tou2/smart-moisture-sensor/moisture-probe/moisture-probe.kicad_pcb

## KiCad design moisture-probe/moisture-probe.kicad_pcb (2026-11-11)

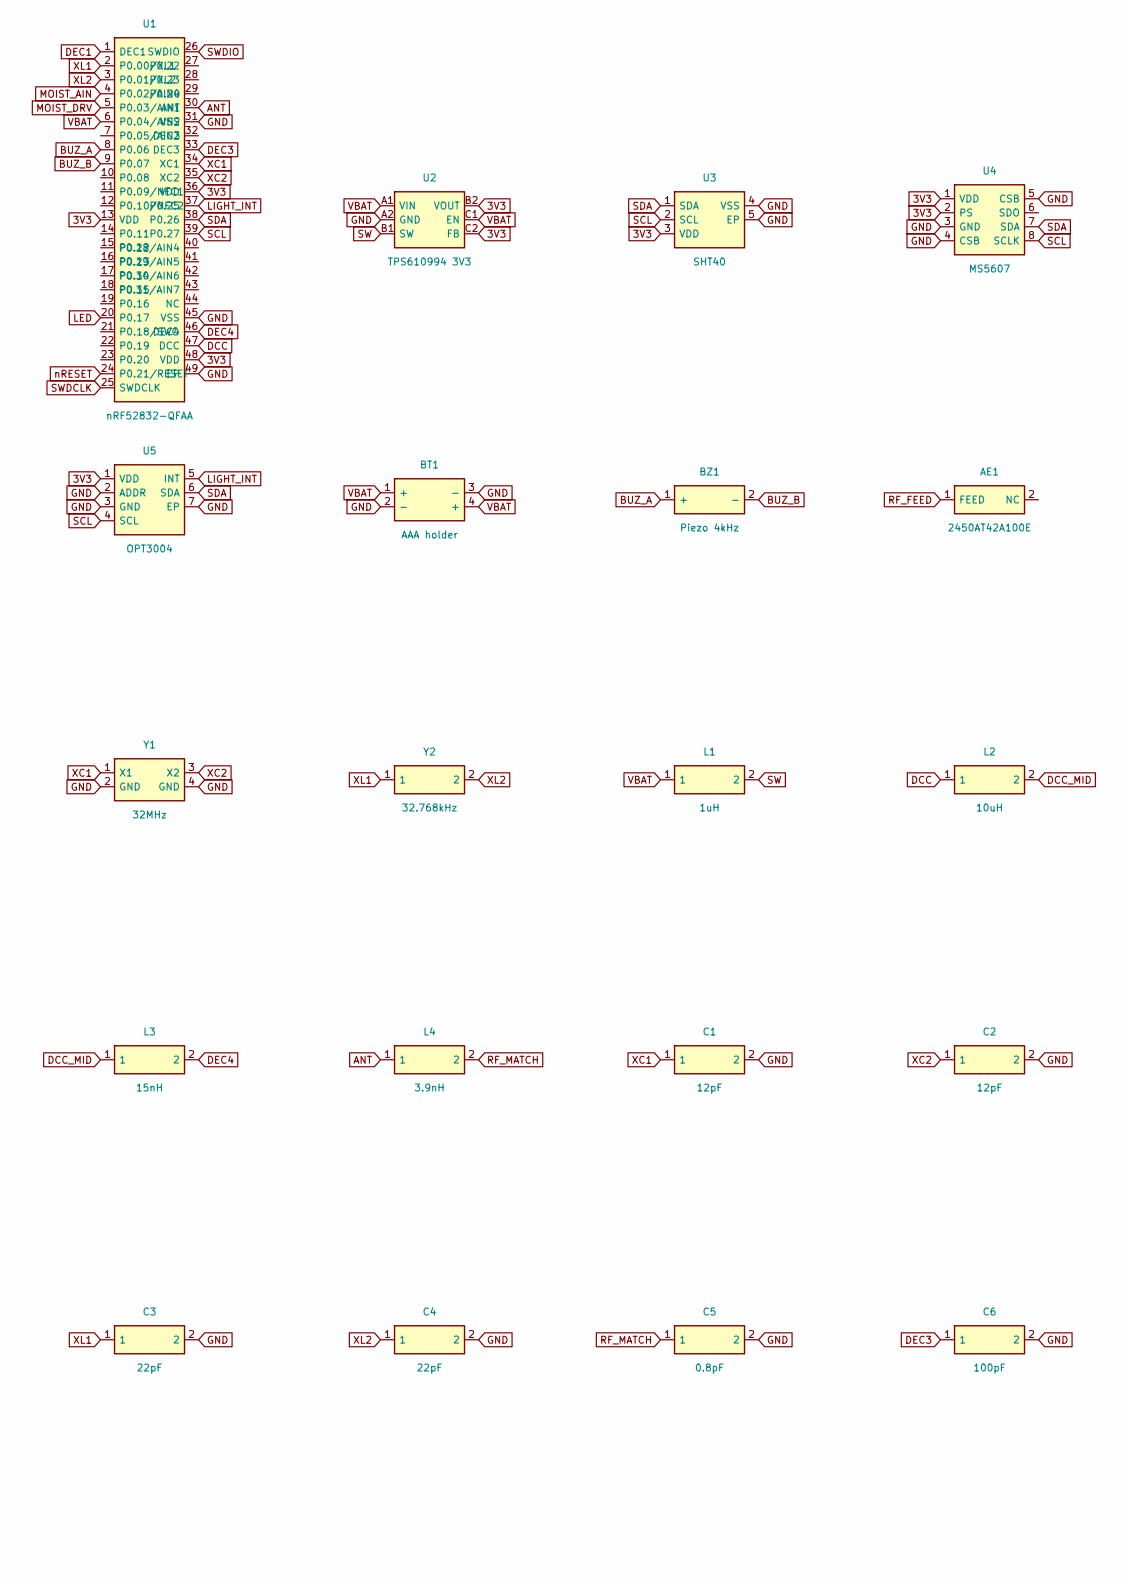
[picture p1: schematic moisture-probe.kicad_sch, part in row 1, column 1]

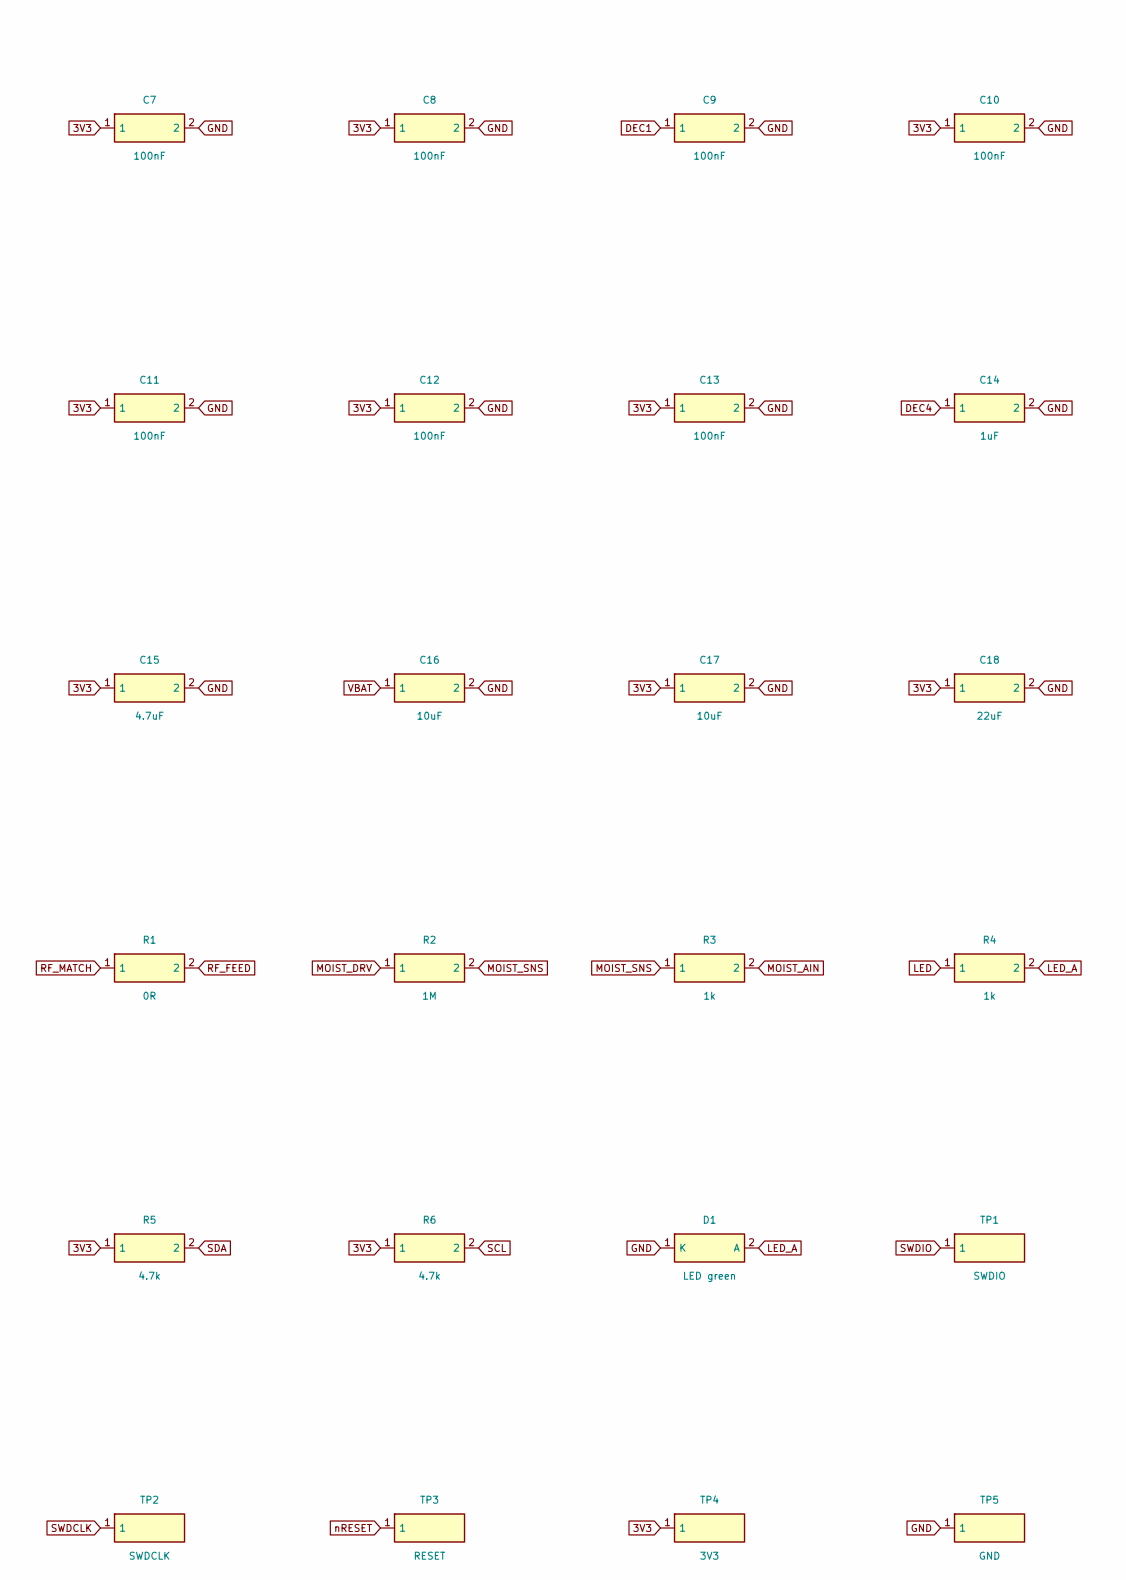
[picture p2: schematic moisture-probe.kicad_sch, part in row 2, column 1]

Parts:
AE1: 2450AT42A100E; C2917719_SMD_5x2mm; LCSC C2917719
BT1: AAA holder; C964881_-; LCSC C964881
BZ1: Piezo 4kHz; C113159_SMD_12x12mm; LCSC C113159
C1, C2: 12pF; C_0402_1005Metric; LCSC C1547
C3, C4: 22pF; C_0402_1005Metric; LCSC C1555
C5: 0.8pF; C_0402_1005Metric; LCSC C327032
C6: 100pF; C_0402_1005Metric; LCSC C1546
C7, C8, C9, C10, C11, C12, C13: 100nF; C_0402_1005Metric; LCSC C1525
C14: 1uF; C_0603_1608Metric; LCSC C15849
C15: 4.7uF; C_0603_1608Metric; LCSC C19666
C16, C17: 10uF; C_0603_1608Metric; LCSC C19702
C18: 22uF; C_0805_2012Metric; LCSC C45783
D1: LED green; LED_0603_1608Metric; LCSC C965806
L1: 1uH; C5349664_SMD_4_4x4_2mm; LCSC C5349664
L2: 10uH; L_0603_1608Metric; LCSC C6807729
L3: 15nH; L_0402_1005Metric; LCSC C98055
L4: 3.9nH; L_0201_0603Metric; LCSC C918993
R1: 0R; R_0402_1005Metric; LCSC C17168
R2: 1M; R_0402_1005Metric; LCSC C26083
R3, R4: 1k; R_0402_1005Metric; LCSC C11702
R5, R6: 4.7k; R_0402_1005Metric; LCSC C25900
TP1: SWDIO; TestPoint_Pad_D1.0mm
TP2: SWDCLK; TestPoint_Pad_D1.0mm
TP3: RESET; TestPoint_Pad_D1.0mm
TP4: 3V3; TestPoint_Pad_D1.0mm
TP5: GND; TestPoint_Pad_D1.0mm
U1: nRF52832-QFAA; C77540_QFN-48-EP_6x6_; LCSC C77540
U2: TPS610994 3V3; C2650335_DSBGA-6; LCSC C2650335
U3: SHT40; C2909890_DFN-4-EP_1_5x1_5_; LCSC C2909890
U4: MS5607; C97627_SMD-8P; LCSC C97627
U5: OPT3004; C2655153_WSON-6-EP_2x2_; LCSC C2655153
Y1: 32MHz; C718072_SMD2016-4P; LCSC C718072
Y2: 32.768kHz; C32346_SMD3215-2P; LCSC C32346

Connections:
3V3: C7.1, C8.1, C10.1, C11.1, C12.1, C13.1, C15.1, C17.1, C18.1, R5.1, R6.1, TP4.1, U1.13 (VDD), U1.36 (VDD), U1.48 (VDD), U2.B2 (VOUT), U2.C2 (FB), U3.3 (VDD), U4.1 (VDD), U4.2 (PS), U5.1 (VDD)
ANT: L4.1, U1.30 (ANT)
BUZ_A: BZ1.1 (+), U1.8 (P0.06)
BUZ_B: BZ1.2 (-), U1.9 (P0.07)
DCC: L2.1, U1.47 (DCC)
DCC_MID: L2.2, L3.1
DEC1: C9.1, U1.1 (DEC1)
DEC3: C6.1, U1.33 (DEC3)
DEC4: C14.1, L3.2, U1.46 (DEC4)
GND: BT1.2 (-), BT1.3 (-), C1.2, C2.2, C3.2, C4.2, C5.2, C6.2, C7.2, C8.2, C9.2, C10.2, C11.2, C12.2, C13.2, C14.2, C15.2, C16.2, C17.2, C18.2, D1.1 (K), TP5.1, U1.31 (VSS), U1.45 (VSS), U1.49 (EP), U2.A2 (GND), U3.4 (VSS), U3.5 (EP), U4.3 (GND), U4.4 (CSB), U4.5 (CSB), U5.2 (ADDR), U5.3 (GND), U5.7 (EP), Y1.2 (GND), Y1.4 (GND)
LED: R4.1, U1.20 (P0.17)
LED_A: D1.2 (A), R4.2
LIGHT_INT: U1.37 (P0.25), U5.5 (INT)
MOIST_AIN: R3.2, U1.4 (P0.02/AIN0)
MOIST_DRV: R2.1, U1.5 (P0.03/AIN1)
MOIST_SNS: R2.2, R3.1
RF_FEED: AE1.1 (FEED), R1.2
RF_MATCH: C5.1, L4.2, R1.1
SCL: R6.2, U1.39 (P0.27), U3.2 (SCL), U4.8 (SCLK), U5.4 (SCL)
SDA: R5.2, U1.38 (P0.26), U3.1 (SDA), U4.7 (SDA), U5.6 (SDA)
SW: L1.2, U2.B1 (SW)
SWDCLK: TP2.1, U1.25 (SWDCLK)
SWDIO: TP1.1, U1.26 (SWDIO)
VBAT: BT1.1 (+), BT1.4 (+), C16.1, L1.1, U1.6 (P0.04/AIN2), U2.A1 (VIN), U2.C1 (EN)
XC1: C1.1, U1.34 (XC1), Y1.1 (X1)
XC2: C2.1, U1.35 (XC2), Y1.3 (X2)
XL1: C3.1, U1.2 (P0.00/XL1), Y2.1
XL2: C4.1, U1.3 (P0.01/XL2), Y2.2
nRESET: TP3.1, U1.24 (P0.21/RESET)

Board: 2 copper layers, 44 parts (0 on the bottom side), 29 nets, no tracks yet.
